Pet-Series/Pet-Mk-IV/doc/README.md

# README: /doc/ 

Sub-folder in the https://github.com/Pet-Series/Pet-Mk-IV repository.</br>
Content: Photo log book and image library.

## **Photos of Pet-Mk.IV**
<table style="width:100%">
  <tr>
    <th>Images</th>
    <th>Idol portrait from 📸 log-book</th>
    <th>admirers and ponder this 🤩</th>
  </tr>
  <tr>
    <td></td>
    <td></td>
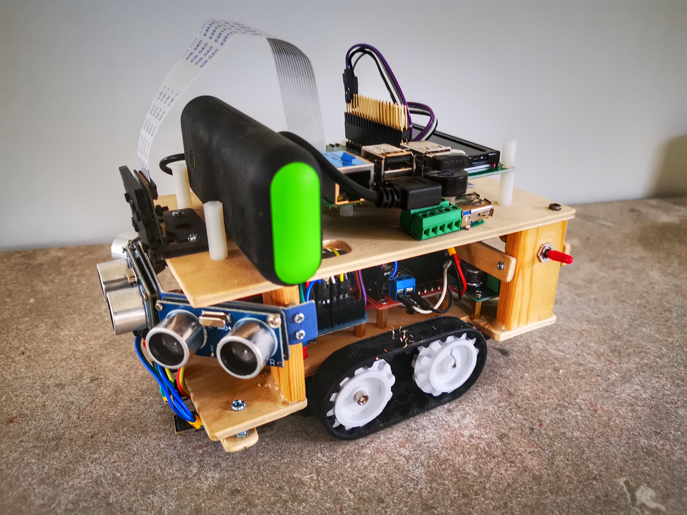
[picture p15: doc/pet_mk_iv-view_frontLeft.jpg]
    <td></td>
  </tr>
  <tr>
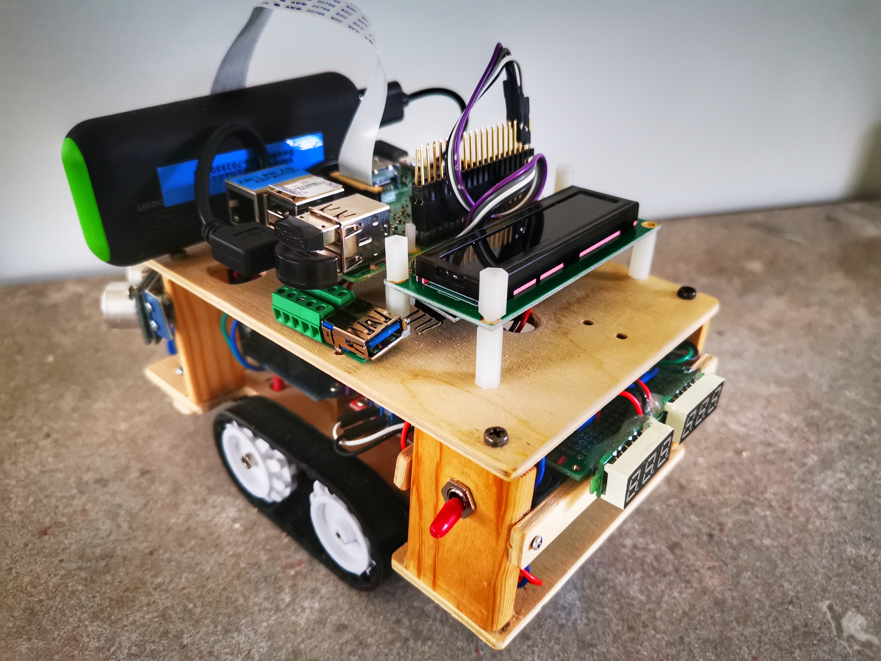
[picture p16: doc/pet_mk_iv-view_rearLeft.jpg]
    <td></td>
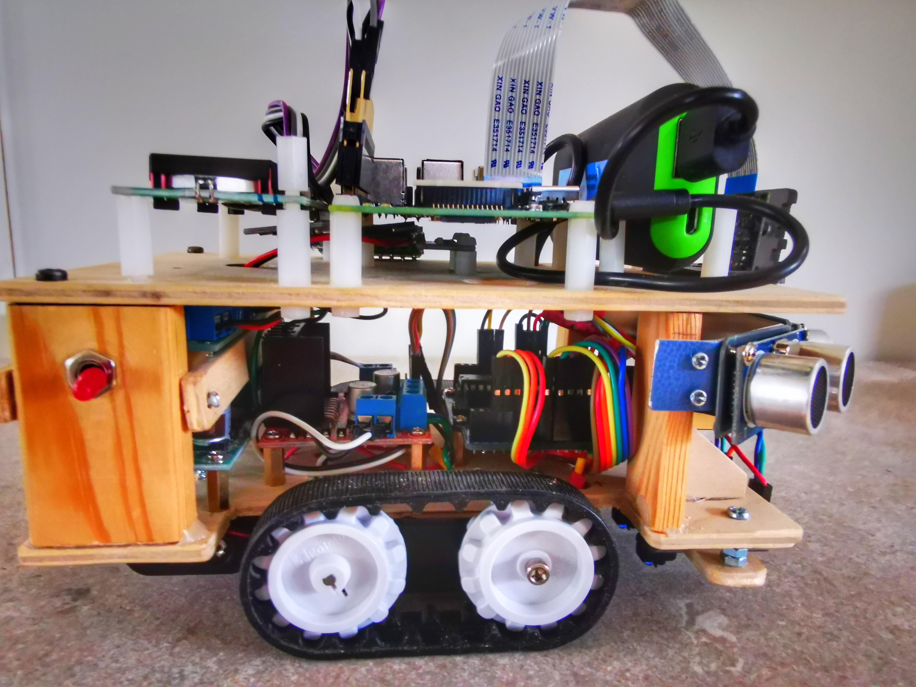
[picture p17: doc/pet_mk_iv-view_right.jpg]
    <td></td>
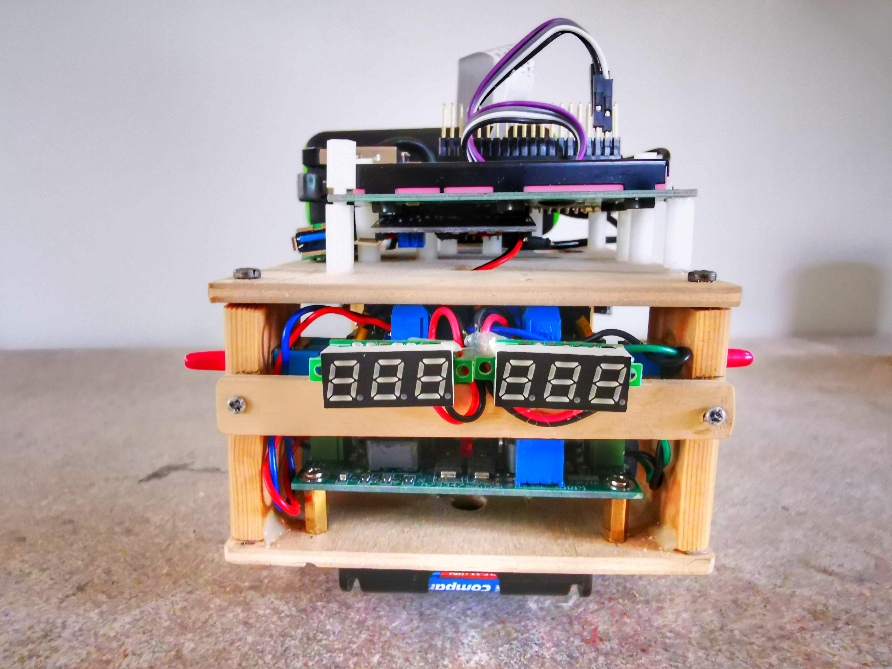
[picture p18: doc/pet_mk_iv-view_rear.jpg]
    <td></td>
  </tr>
  <tr>
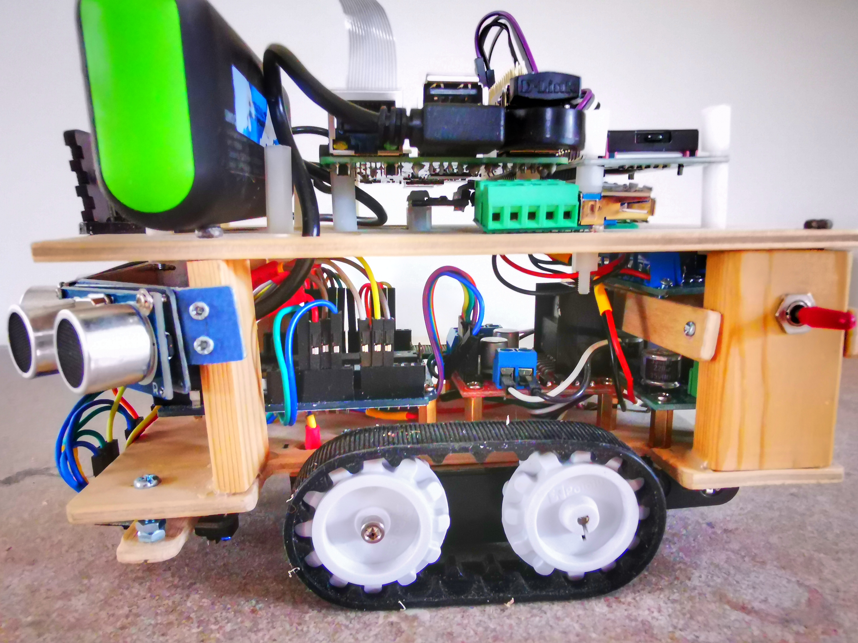
[picture p19: doc/pet_mk_iv-view_left.jpg]
    <td></td>
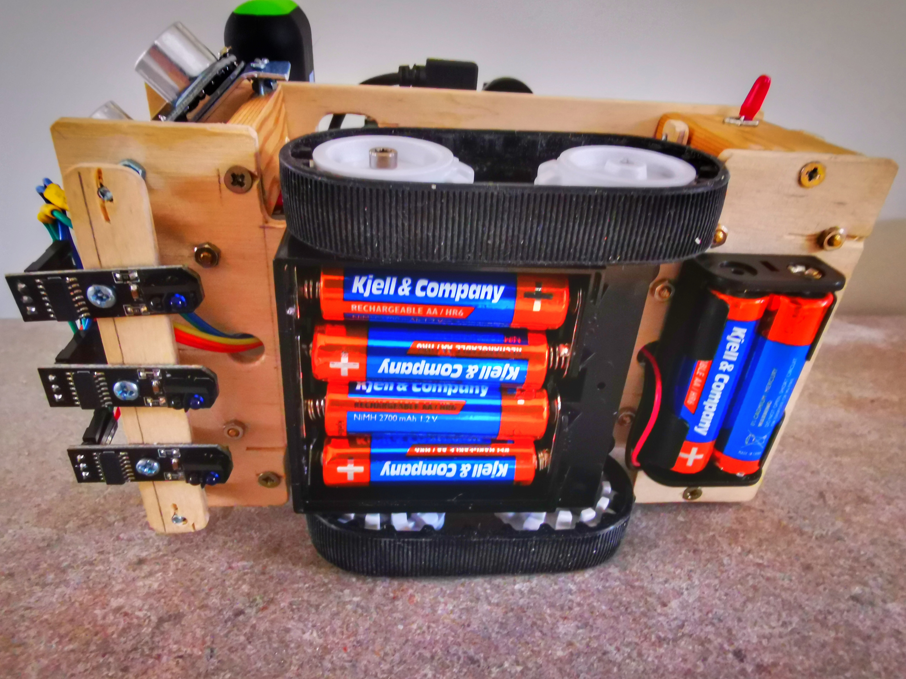
[picture p20: doc/pet_mk_iv-battery_compartment.jpg]
    <td></td>
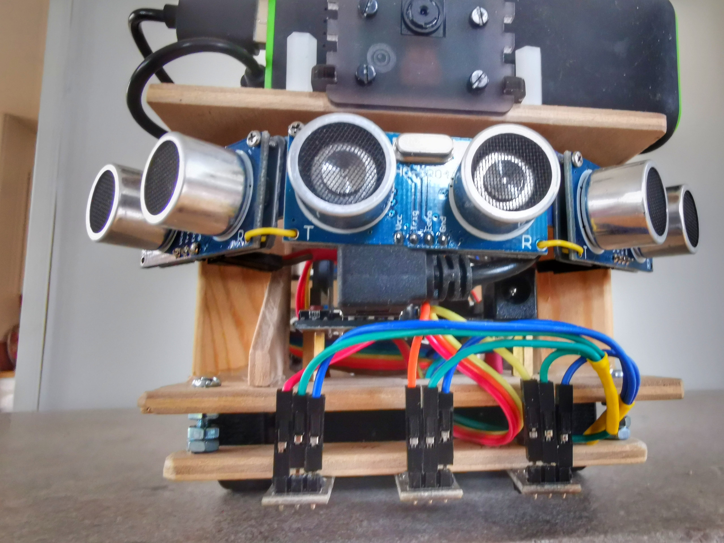
[picture p21: doc/pet_mk_iv-view_front.jpg]
    <td></td>
  </tr>
   <tr>
    <td></td>
    <td></td>
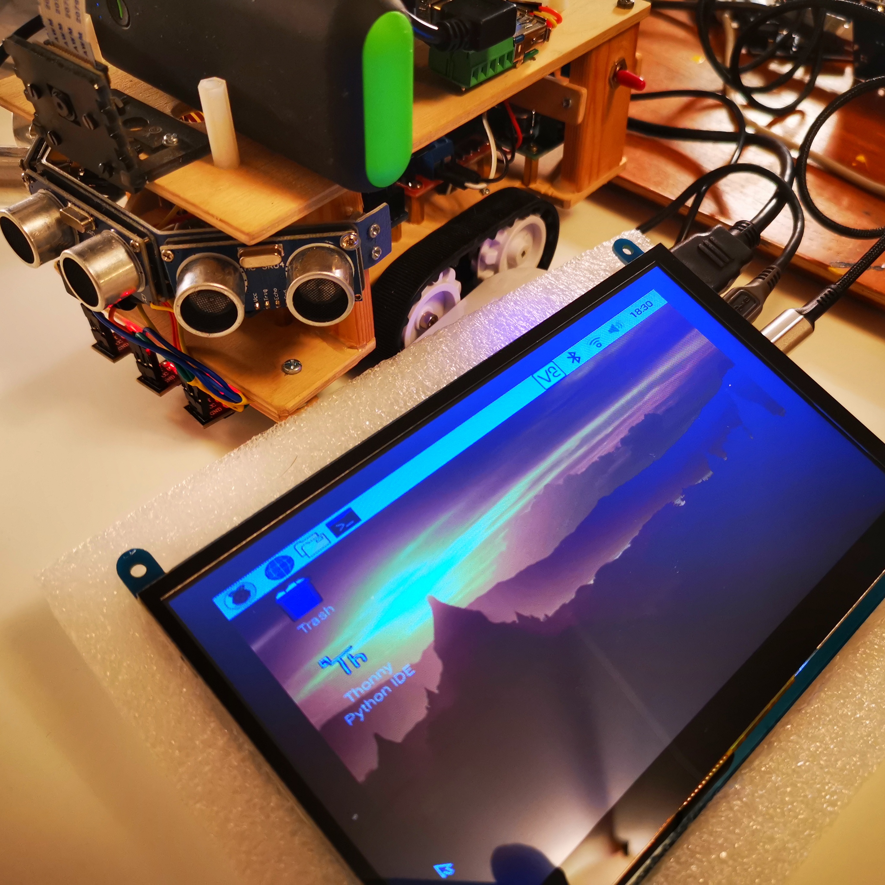
[picture p22: doc/pet_mk_iv-with_7inch_LCD_screen.jpg]
    <td></td>
  </tr>
  <tr>
    <td></td>
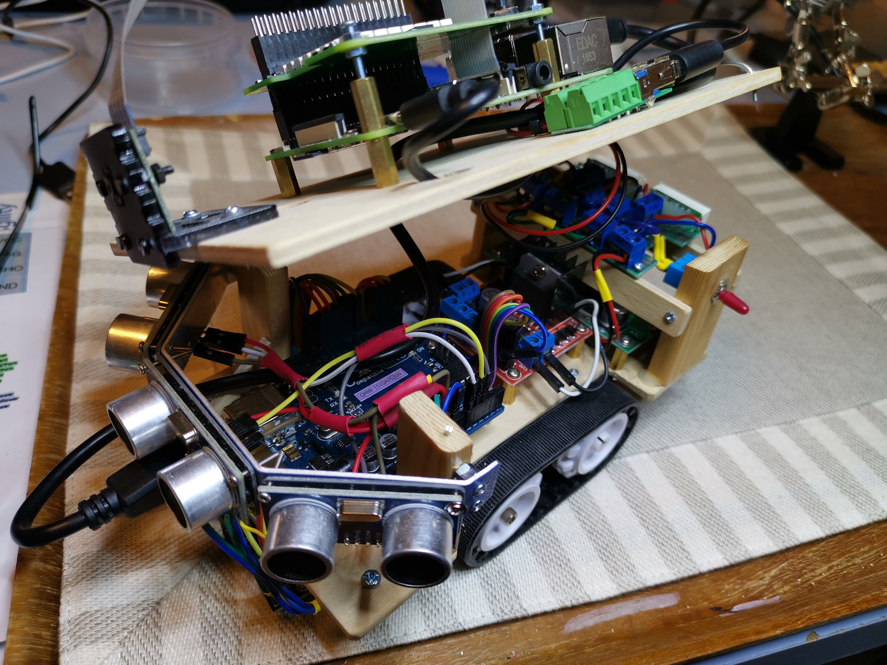
[picture p23: doc/pet_mk_iv-build_phase20.jpg]
    <td></td>
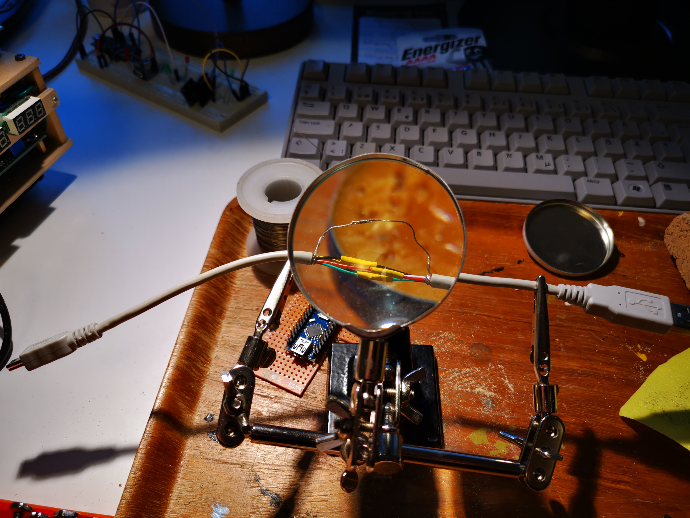
[picture p24: doc/pet_mk_iv-making_cabels.jpg]
    <td></td>
  </tr>
</table>

## **Images of the virtual twin:**
<table style="width:100%">
  <tr>
    <th>Images</th>
    <th>Idol rendering from RViz and Gazebo</th>
    <th></th>
  </tr>
  <tr>
    <td></td>
    <td></td>
    <td></td>
  </tr>
  <tr>
    <td></td>
    <td></td>
    <td</td>
  </tr>
</table>

<hr />
<br />

## **Drawing/Schemas:**
<table style="width:100%">
  <tr>
    <th>Images</th> 
    <th>Wiring🔌diagram</th>
    <th>📑</th>
  </tr>
  <tr>
    <td><br>Circuit Diagram - UNO</td>
    <td><br>Circuit Diagram - NANO</td>
    <td><br>Circuit Diagram - RPi</td>
  </tr>
  <tr>
    <td><br>PowerDistributionSchema</td>
    <td><br>PowerDistributionBoard</td>
    <td></td>
  </tr>
</table>

<hr />
<br />
 
## Test images: 
### A picture to the right (HTML formatted (48x48px))

<hr />
<br />

<table style="width:100%">
  <tr>
    <th>1️⃣</th>
    <th>2️⃣</th>
    <th>3️⃣</th>
  </tr>
  <tr>
    <td></td>
    <td></td>
    <td></td>
  </tr>
  <tr>
    <td></td>
    <td>n/a</td>
    <td>n/a</td>
  </tr>
</table>
<hr />
<br />

### Avatar
