Pet-Series/Pet-Mk-IV/pet_mk_iv_description/README.md

# README.md: /pet_mk_iv_description/ #

Sub-folder in the https://github.com/Pet-Series/Pet-Mk-IV repository.</br>

## **What is this folder for?** ##

* This package contains the description of our robots and end effectors in terms of kinematics, joint limits, visual surfaces and collision space. 
  - The collision space is a simplified version of the visual description used to improve performance of collision checks. 
* The descriptions are based on the URDF format according to the URDF XML documentation. Also using .xacro-macro format files.
<table>
  <tr>
     <td>
        
    </td>
    <td>
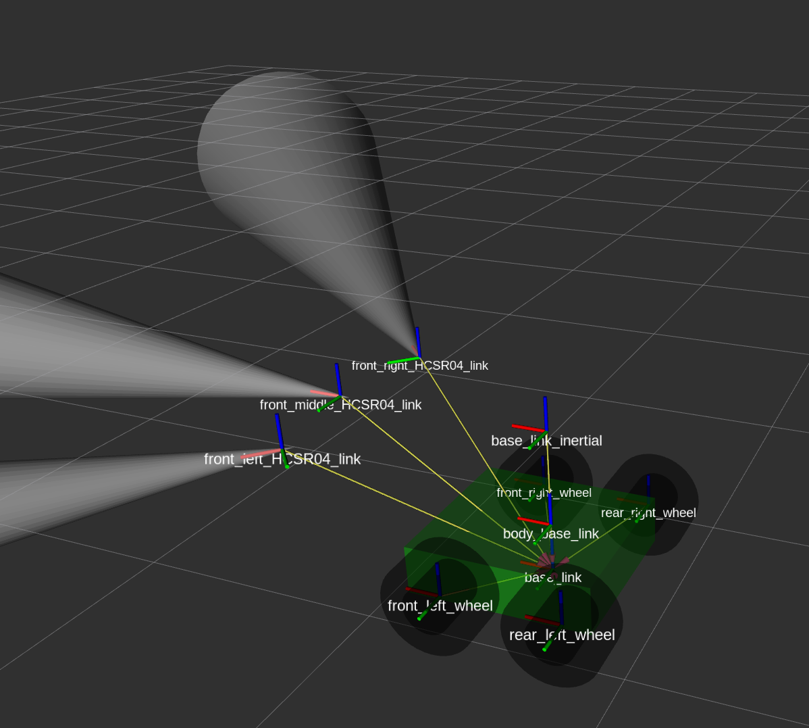
[picture p25: doc/pet_mk_iv-chassis_PololuZumo_and_sensor_link_tree.png]
        
    </td>
    <td>
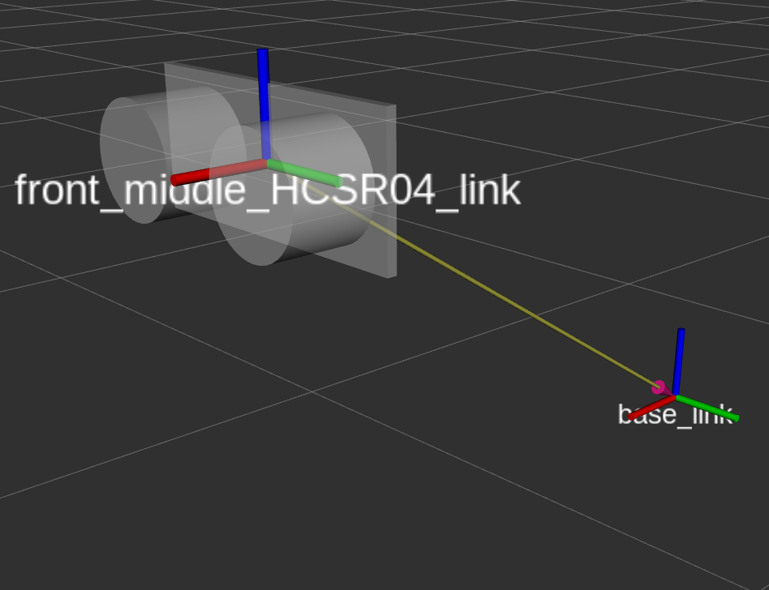
[picture p26: doc/pet_mk_iv-sensor_hc_sr04_sonarRange.urdf.xacro.png]
        
    </td>
  </tr>
</table>

## **Who do I talk to?** ##

* Repo owner: "Kullken" <karl.viktor.kull@gmail.com>
* Folder contributor: "SeniorKullken" <stefan.kull@gmail.com>
