Pet-Series/Pet-Mk-IV/Project_stuff/Images/readme.md

# Photo log book and image library
## **Photos:**
<table style="width:100%;background-color:#dddddd">
  <tr>
    <th>Images</th>
    <th>...from 📸 log book</th>
    <th>admirers and ponder this 🤩</th>
  </tr>
  <tr>
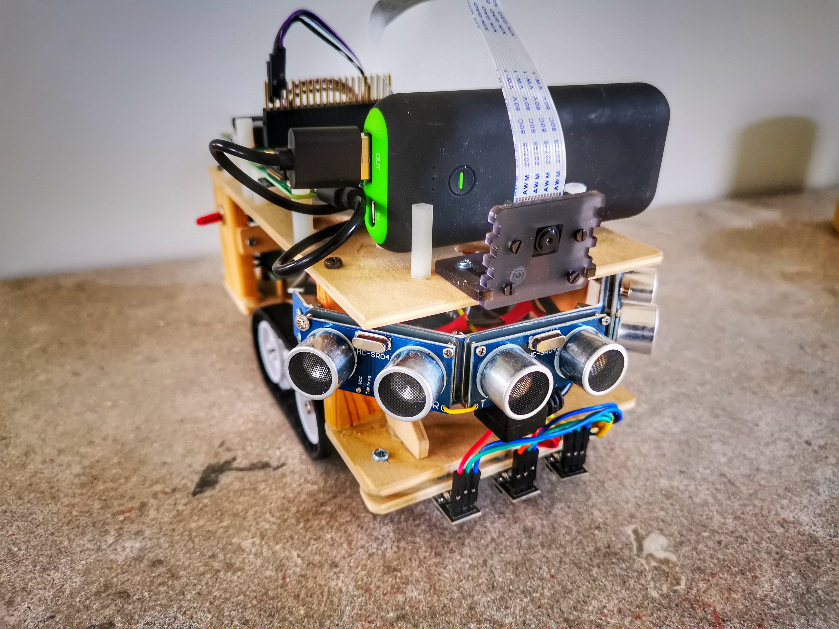
[picture p36: Project_stuff/Images/2019-09-09_121443-01.jpg]
    <td></td>
    <td></td>
    <td></td>
  </tr>
  <tr>
    <td></td>
    <td></td>
    <td></td>
  </tr>
  <tr>
    <td></td>
    <td></td>
    <td></td>
  </tr>
   <tr>
    <td></td>
    <td></td>
    <td>
    </td>
  </tr>
  <tr>
    <td></td>
    <td></td>
    <td></td>
  </tr>
   <tr>
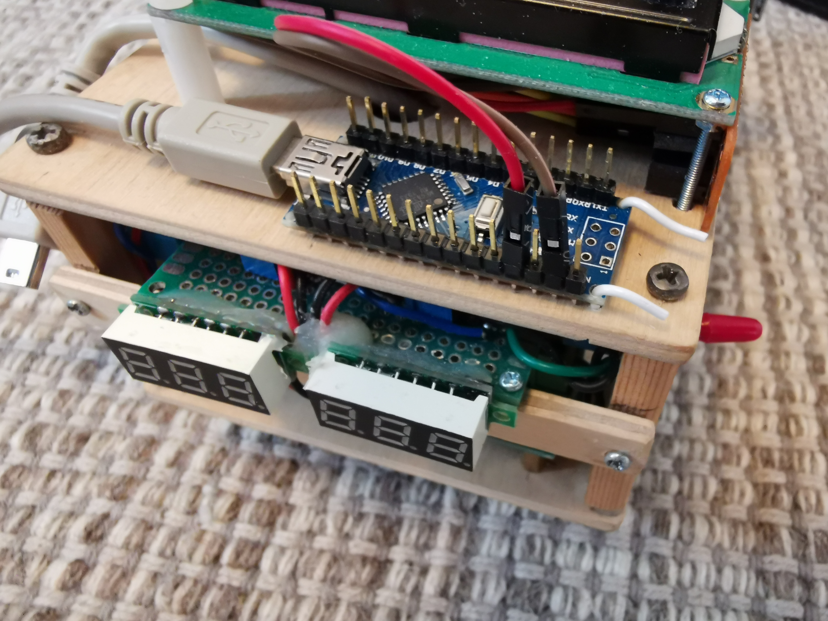
[picture p37: Project_stuff/Images/2020-05-15_123445.jpg]
    <td></td>
    <td></td>
    <td></td>
  </tr>
</table>
<hr />
<br />

## **Drawing/Schemas:**
<table style="width:100%">
  <tr>
    <th>Images</th> 
    <th>Wiring🔌diagram</th>
    <th>📑</th>
  </tr>
  <tr>
    <td><br>Circuit Diagram - UNO</td>
    <td><br>Circuit Diagram - NANO</td>
    <td><br>Circuit Diagram - RPi</td>
  </tr>
  <tr>
    <td><br>PowerDistributionSchema</td>
    <td><br>PowerDistributionBoard</td>
    <td></td>
  </tr>
</table>

<hr />
<br />
 
## Test images: 
### A picture to the right (HTML formatted (48x48px))

<hr />
<br />

<table style="width:100%">
  <tr>
    <th>1️⃣</th>
    <th>2️⃣</th>
    <th>3️⃣</th>
  </tr>
  <tr>
    <td></td>
    <td></td>
    <td></td>
  </tr>
  <tr>
    <td></td>
    <td>n/a</td>
    <td>n/a</td>
  </tr>
</table>
<hr />
<br />

### Avatar
