Pet-Series/Pet-Mk-IV/Linux/README.md

# README #

Folder in the https://github.com/kullken/Pet-Mk-IV repository.
Folder: ~/ros_ws/src/Pet-Mk-IV/pet_mk_iv_simulation/src/Linux

### What is this folder for? ###

Linux related files to be stored locally in Raspberry Pi (Not a ROS-package)
Utility scripts/setup files is to be run, outside ROS, by Linux during Linux-boot-up sequence.

### How do I get set up? ###

File locations:
* "**/home/pi/ros_ws/src/Pet-Mk-IV/Linux**" <- Files in this folder.
* "**/etc**" <- Files in the sub-folder "~/etc/*"

### Who do I talk to? ###

* Repo owner: "Kullken" <karl.viktor.kull@gmail.com>
* Folder contributor: "SeniorKullken" <stefan.kull@gmail.com>

###
:warning:Be aware:warning: You might get some "*close to hardware experiences*:neckbeard:".
