Pet-Series/Pet-Mk-IV/pet_mk_iv_description/mesh/pet_mk_iv_body.stl

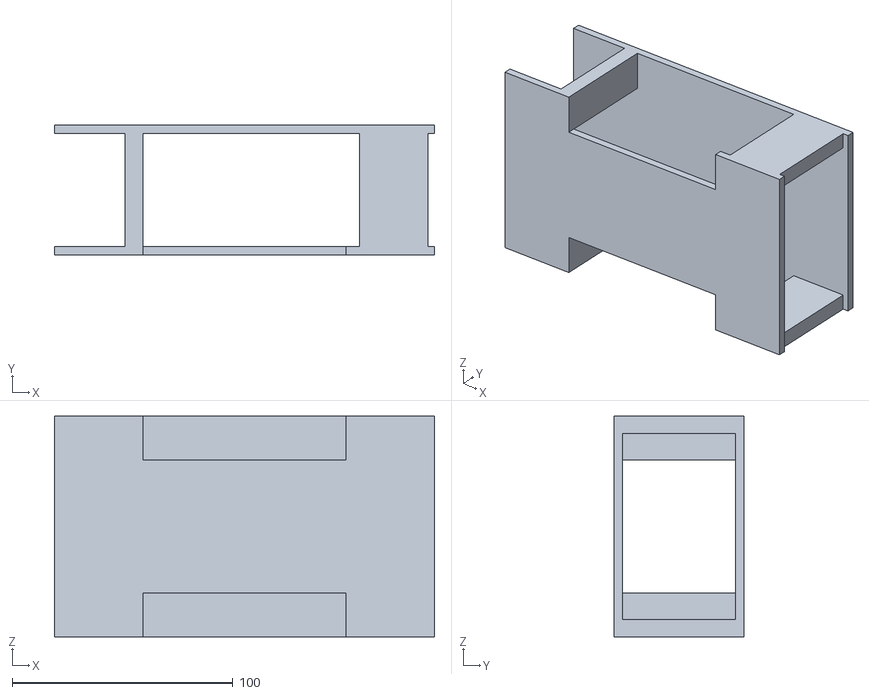
[picture p38: CAD file, 2021-06-19]
pet_mk_iv_description/mesh/pet_mk_iv_body.stl
172.0 x 59.0 x 100.0
