Pet-Series/Pet-Mk-IV/(threads)

Thread 2 (2019-10-12):

Setup raspiKull2 (Workbench/HIL)

kullken, 2019-10-12:
**Objective:**
- Setup a common workbench-RPi as an HIL-test bed (Hardware In the Loop)

**Checklist:**
- [x] Install Raspian melodic
- [x] Install ROS melodic
   - [x] Install ROS packages from Pet-Mk-IV github-project -> ~/ros_ws
         _Consider: What is common vs. What is unique for each Pet?_
   - [x] Custom ROS messages on arduino
- [x] Setup SSH
    - [x] Enable OpenSSH + add keys -> GitHub
      _See also: <#13 Connect target(RPi) systems to github-project via SSH-keys>_
    - [x] Enable OpenSSH + add keys for incoming traffic <- Viktor's "Tenebrous"
    - [x] Enable OpenSSH + add keys for incoming traffic <- Stefan's "Frigolit"
      ~~_See also: <Setting up developing env. on "Frigolit" #24>_~~
    - [x] Enable OpenSSH + add keys for incoming traffic <- Stefan's "Scania/Jobb" (aka "RD0067755")
- [x] Install Arduino IDE + library like NewPing

**Prerequisites:**
- [x] One RPi Ver 2B
- [x] One SD-card 8-16GB
- [x] Screen, Keyboard, Mouse

SeniorKullken, 2023-06-15:
Done long time ago...

Closed 2023-06-15.

Thread 9 (2019-10-20):

Custom ros.h in arduino sketch.

kullken, 2019-10-20:
A custom ros.h is needed to decrease memory buffer size used by rosserial. Currently the sketch is not compiling: "ros.h:4:29: error: ros/node_handle.h: No such file or directory".

SeniorKullken, 2020-10-07:
No relevant right now... I think :-)

Closed 2020-10-07.

Thread 22 (2020-03-11):

Embed ROS LCD-Publisher into mission ctrl. nodes

SeniorKullken, 2020-03-11:
**Objective:** Publish state/decision on LCD-display while running.

**Definition of done:** Update "Publisher" in `test_obstacle_detect_stop_turn.py`
- [x] Dist. sensors ▶️ `self.row1_pub = rospy.Publisher("lcd_display/row1", String, queue_size=10)`
- [x] State/Decisions   ▶️ `self.row2_pub = rospy.Publisher("lcd_display/row2", String, queue_size=10)`

**Prerequisites**: Existing subscriber for Topic  lcd_display/row1 and lcd_display/row1. (See #19)

SeniorKullken, 2020-10-07:
"Run Forrest run..."
"Obstacles all over the place"
Implemented & Tested

Closed 2020-10-07.

Thread 25 (2020-04-02):

HID: Auxiliary ROS-serial node (ArduinoNano) as IR-remote reciver

SeniorKullken, 2020-04-02:
**Objective:**
Human Interface Device(HID)
- Remote Start & stop via IR-remote.

**Definition of done:**
- [x] ROS-Serial on extra (Auxiliary) Arduino Nano.
- [x] Set up $udev rules for "/dev/ArduinoNano%c" and "/dev/ArdunioUni%c"
- [x] Hardware/Mechanics Done: IR-sensor + Arduino Ctrl mounted on Pet-Mk.IV
- [x] Implement support(subscribers) for remote start/stop-Topic.
- [x] Implement ROS-Serial for Arduino-node publishing "start/stop"-node.

**Prerequisites**:
- [x] Unit test done

SeniorKullken, 2020-10-07:
Implemented & tested

Closed 2020-10-07.

Thread 29 (2020-06-27):

HID: Flash/Strobe indicator (aka "Saftblandare")

SeniorKullken, 2020-06-27:
**Objective:**
Human Interface Device(HID)
- Visible motion feedback/Indicator/warning on top of vehicle (aka "Saftblandaren").
- Light with the following characteristics...
  > 1. Fast rotate
  > 2. Slow rotate
  > 3. Flash
  > 4. Strobe
  > 5. Off

**Definition of done:**
- [x] Hardware/Mechanics Done: Flash light connected to ROS-serial node "/dev/ArduinoNano0"
- [x] New message type for manipulating/controlling the characteristics of the flashlight.
- [x] Implement support(subscriber) for changing characteristics of the flashlight

**Prerequisites**:
- [x] #25 ROS-Serial on extra (Auxiliary) Arduino Nano

**Known issues that need to be manage**:
- Problem combining ROS Serial & servo-library.
  https://answers.ros.org/question/341697/unable-to-operate-servo-with-rosserial_arduino/
  http://wiki.ros.org/rosserial_arduino/Tutorials/Servo%20Controller

SeniorKullken, 2020-10-07:
Implemented & tested

Closed 2020-10-07.
