Pet-Series/Pet-Mk-IV/diagnos/RPi_OLEDdisplay_I2C/status.py

# Copyright (c) 2017 Adafruit Industries
# Author: Tony DiCola & James DeVito
#
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
import Adafruit_GPIO.SPI as SPI
import Adafruit_SSD1306

from PIL import Image
from PIL import ImageDraw
from PIL import ImageFont

import subprocess
import socket

# Raspberry Pi pin configuration:
RST = None     # on the PiOLED this pin isnt used
# Note the following are only used with SPI:
DC = 23
SPI_PORT = 0
SPI_DEVICE = 0

# 128x32 display with hardware I2C:
#disp = Adafruit_SSD1306.SSD1306_128_32(rst=RST)

# 128x64 display with hardware I2C:
disp = Adafruit_SSD1306.SSD1306_128_64(rst=RST)

# Note you can change the I2C address by passing an i2c_address parameter like:
# disp = Adafruit_SSD1306.SSD1306_128_64(rst=RST, i2c_address=0x3C)

# Alternatively you can specify an explicit I2C bus number, for example
# with the 128x32 display you would use:
# disp = Adafruit_SSD1306.SSD1306_128_32(rst=RST, i2c_bus=2)

# 128x32 display with hardware SPI:
# disp = Adafruit_SSD1306.SSD1306_128_32(rst=RST, dc=DC, spi=SPI.SpiDev(SPI_PORT, SPI_DEVICE, max_speed_hz=8000000))

# 128x64 display with hardware SPI:
# disp = Adafruit_SSD1306.SSD1306_128_64(rst=RST, dc=DC, spi=SPI.SpiDev(SPI_PORT, SPI_DEVICE, max_speed_hz=8000000))

# Alternatively you can specify a software SPI implementation by providing
# digital GPIO pin numbers for all the required display pins.  For example
# on a Raspberry Pi with the 128x32 display you might use:
# disp = Adafruit_SSD1306.SSD1306_128_32(rst=RST, dc=DC, sclk=18, din=25, cs=22)

# Initialize library.
disp.begin()

# Clear display.
disp.clear()
disp.display()

# Create blank image for drawing.
# Make sure to create image with mode '1' for 1-bit color.
width = disp.width
height = disp.height
image = Image.new('1', (width, height))
#print ("Width=", width)
#print ("Height=", height)

# Get drawing object to draw on image.
draw = ImageDraw.Draw(image)

# Draw a black filled box to clear the image.
draw.rectangle((0,0,width,height), outline=0, fill=0)

# Draw some shapes.
# First define some constants to allow easy resizing of shapes.
padding = -2
top = padding
bottom = height-padding
# Move left to right keeping track of the current x position for drawing shapes.
x = 0


# Load default font.
font = ImageFont.load_default()

# Alternatively load a TTF font.  Make sure the .ttf font file is in the same directory as the python script!
# Some other nice fonts to try: http://www.dafont.com/bitmap.php
# font = ImageFont.truetype('Minecraftia.ttf', 8)

while True:

    # Draw a black filled box to clear the image.
    draw.rectangle((0,0,width,height), outline=0, fill=0)

    # Shell scripts for system monitoring from here : https://unix.stackexchange.com/questions/119126/command-to-display-memory-usage-disk-usage-and-cpu-load
    HostName = socket.gethostname()
    
#    s = socket.socket(socket.AF_INET, socket.SOCK_DGRAM)
#    s.connect(("8.8.8.8", 80))
#    IP = s.getsockname()[0]
    
    IP = (([ip for ip in socket.gethostbyname_ex(socket.gethostname())[2] if not ip.startswith("127.")] or [[(s.connect(("8.8.8.8", 53)), s.getsockname()[0], s.close()) for s in [socket.socket(socket.AF_INET, socket.SOCK_DGRAM)]][0][1]]) + ["no IP found"])[0]
    
    #cmd = "hostname -I | cut -d\' \' -f1"
    #IP = subprocess.check_output(cmd, shell = True ).decode('utf-8')

    cmd = "top -bn1 | grep load | awk '{printf \"CPU Load: %.2f\", $(NF-2)}'"
    CPU = subprocess.check_output(cmd, shell = True ).decode('utf-8')
    
    cmd = "free -m | awk 'NR==2{printf \"Mem: %s/%sMB %.2f%%\", $3,$2,$3*100/$2 }'"
    MemUsage = subprocess.check_output(cmd, shell = True ).decode('utf-8')
    cmd = "df -h | awk '$NF==\"/\"{printf \"Disk: %d/%dGB %s\", $3,$2,$5}'"
    Disk = subprocess.check_output(cmd, shell = True ).decode('utf-8')

    # Write some lines of text.
    draw.text((x, top),    "Host: " + str(HostName),font=font, fill=255)
    draw.text((x, top+9),  "IP: " + str(IP),font=font, fill=255)
    draw.text((x, top+30),  str(CPU) + "%",        font=font, fill=255)
    draw.text((x, top+40), str(MemUsage),   font=font, fill=255)
    draw.text((x, top+50), str(Disk),       font=font, fill=255)
#    draw.text((x, top),    "Host: " + str(HostName),font=font, fill=255)
#    draw.text((x, top+8),  "IP: " + str(IP),font=font, fill=255)
#    draw.text((x, top+16),  str(CPU) + "%",        font=font, fill=255)
#    draw.text((x, top+24), str(MemUsage),   font=font, fill=255)
#    draw.text((x, top+32), str(Disk),       font=font, fill=255)

    # Display image.
    disp.image(image)
    disp.display()
    time.sleep(.1)
