Pet-Series/Pet-Mk-IV/diagnos/RPi_4chADconverter(ADS1115).py

#!/usr/bin/env python3
# coding = utf-8
 
################################################# ################################################# #########
### Copyright by Joy-IT
### Published under Creative Commons Attribution-NonCommercial-ShareAlike 3.0 Unported License
### Commercial use only after permission is requested and granted
###
### KY-053 Analog Digital Converter - Raspberry Pi Python Code Example
###
################################################# ################################################# #########
import time
import board
import busio
import adafruit_ads1x15.ads1115 as ADS
from adafruit_ads1x15.analog_in import AnalogIn

# Create the I2C bus
i2c = busio.I2C (board.SCL, board.SDA)

# Create the ADC object using the I2C bus
ads = ADS.ADS1115 (i2c)

# Create single-ended input on channels
chan0 = AnalogIn (ads, ADS.P0)  # nc.
chan1 = AnalogIn (ads, ADS.P1)  # Down=3.3v...Up=0.0v
chan2 = AnalogIn (ads, ADS.P2)  # CW=3.3v...CCW=0.0v
chan3 = AnalogIn (ads, ADS.P3)  # Left=3.3v...Right=0.0v



while True:
    print ("channel 0:", "{:> 5} \ t {:> 5.3f}". format (chan0.value, chan0.voltage))
    print ("channel 1:", "{:> 5} \ t {:> 5.3f}". format (chan1.value, chan1.voltage))
    print ("channel 2:", "{:> 5} \ t {:> 5.3f}". format (chan2.value, chan2.voltage))
    print ("channel 3:", "{:> 5} \ t {:> 5.3f}". format (chan3.value, chan3.voltage))
    print ("----------------------------------------------- ---- ")
    time.sleep (1)
