Pet-Series/Pet-Mk-IV/diagnos/RPi_Engine(L298N)_RPi/L298NHBridge.py

#!/usr/bin/env python
# coding: latin-1

# Autor:	Ingmar Stapel
# Date:		20141229
# Version:	1.0
# Homepage:	www.raspberry-pi-car.com

# This module is designed to control two motors with a L298N H-Bridge

# Use this module by creating an instance of the class. To do so call the Init function, then command as desired, e.g.
# import L298NHBridge
# HBridge = L298NHBridge.L298NHBridge()
# HBridge.Init()

# Import the libraries the class needs
import RPi.GPIO as io
io.setmode(io.BCM)

# Constant values
PWM_MAX                 = 100

# Disable warning from GPIO
io.setwarnings(False)

# Here we configure the GPIO settings for the left and right motors spinning direction. 
# It defines the four GPIO pins used as input on the L298 H-Bridge to set the motor mode (forward, reverse and stopp).

leftmotor_in1_pin = 27
leftmotor_in2_pin = 22
io.setup(leftmotor_in1_pin, io.OUT)
io.setup(leftmotor_in2_pin, io.OUT)

rightmotor_in1_pin = 24
rightmotor_in2_pin = 25
io.setup(rightmotor_in1_pin, io.OUT)
io.setup(rightmotor_in2_pin, io.OUT)

io.output(leftmotor_in1_pin, False)
io.output(leftmotor_in2_pin, False)
io.output(rightmotor_in1_pin, False)
io.output(rightmotor_in2_pin, False)

# Here we configure the GPIO settings for the left and right motors spinning speed. 
# It defines the two GPIO pins used as input on the L298 H-Bridge to set the motor speed with a PWM signal.

leftmotorpwm_pin = 4
rightmotorpwm_pin = 17

io.setup(leftmotorpwm_pin, io.OUT)
io.setup(rightmotorpwm_pin, io.OUT)

leftmotorpwm = io.PWM(leftmotorpwm_pin,100)
rightmotorpwm = io.PWM(rightmotorpwm_pin,100)

leftmotorpwm.start(0)
leftmotorpwm.ChangeDutyCycle(0)

rightmotorpwm.start(0)
rightmotorpwm.ChangeDutyCycle(0)

		
def setMotorMode(motor, mode):

# setMotorMode()

# Sets the mode for the L298 H-Bridge which motor is in which mode.

# This is a short explanation for a better understanding:
# motor		-> which motor is selected left motor or right motor
# mode		-> mode explains what action should be performed by the H-Bridge

# setMotorMode(leftmotor, reverse)	-> The left motor is called by a function and set into reverse mode
# setMotorMode(rightmotor, stopp)	-> The right motor is called by a function and set into stopp mode

	if motor == "leftmotor":
		if mode == "reverse":
			io.output(leftmotor_in1_pin, True)
			io.output(leftmotor_in2_pin, False)
		elif  mode == "forward":
			io.output(leftmotor_in1_pin, False)
			io.output(leftmotor_in2_pin, True)
		else:
			io.output(leftmotor_in1_pin, False)
			io.output(leftmotor_in2_pin, False)
			
	elif motor == "rightmotor":
		if mode == "reverse":
			io.output(rightmotor_in1_pin, False)
			io.output(rightmotor_in2_pin, True)		
		elif  mode == "forward":
			io.output(rightmotor_in1_pin, True)
			io.output(rightmotor_in2_pin, False)		
		else:
			io.output(rightmotor_in1_pin, False)
			io.output(rightmotor_in2_pin, False)
	else:
		io.output(leftmotor_in1_pin, False)
		io.output(leftmotor_in2_pin, False)
		io.output(rightmotor_in1_pin, False)
		io.output(rightmotor_in2_pin, False)

def setMotorLeft(power):

# SetMotorLeft(power)

# Sets the drive level for the left motor, from +1 (max) to -1 (min).

# This is a short explanation for a better understanding:
# SetMotorLeft(0)     -> left motor is stopped
# SetMotorLeft(0.75)  -> left motor moving forward at 75% power
# SetMotorLeft(-0.5)  -> left motor moving reverse at 50% power
# SetMotorLeft(1)     -> left motor moving forward at 100% power

	if power < 0:
		# Reverse mode for the left motor
		setMotorMode("leftmotor", "reverse")
		pwm = -int(PWM_MAX * power)
		if pwm > PWM_MAX:
			pwm = PWM_MAX
	elif power > 0:
		# Forward mode for the left motor
		setMotorMode("leftmotor", "forward")
		pwm = int(PWM_MAX * power)
		if pwm > PWM_MAX:
			pwm = PWM_MAX
	else:
		# Stopp mode for the left motor
		setMotorMode("leftmotor", "stopp")
		pwm = 0
#	print "SetMotorLeft", pwm
	leftmotorpwm.ChangeDutyCycle(pwm)

def setMotorRight(power):

# SetMotorRight(power)

# Sets the drive level for the right motor, from +1 (max) to -1 (min).

# This is a short explanation for a better understanding:
# SetMotorRight(0)     -> right motor is stopped
# SetMotorRight(0.75)  -> right motor moving forward at 75% power
# SetMotorRight(-0.5)  -> right motor moving reverse at 50% power
# SetMotorRight(1)     -> right motor moving forward at 100% power

	if power < 0:
		# Reverse mode for the right motor
		setMotorMode("rightmotor", "reverse")
		pwm = -int(PWM_MAX * power)
		if pwm > PWM_MAX:
			pwm = PWM_MAX
	elif power > 0:
		# Forward mode for the right motor
		setMotorMode("rightmotor", "forward")
		pwm = int(PWM_MAX * power)
		if pwm > PWM_MAX:
			pwm = PWM_MAX
	else:
		# Stopp mode for the right motor
		setMotorMode("rightmotor", "stopp")
		pwm = 0
#	print "SetMotorRight", pwm
	rightmotorpwm.ChangeDutyCycle(pwm)

def exit():
# Program will clean up all GPIO settings and terminates
	io.output(leftmotor_in1_pin, False)
	io.output(leftmotor_in2_pin, False)
	io.output(rightmotor_in1_pin, False)
	io.output(rightmotor_in2_pin, False)
	io.cleanup()
