Pet-Series/Pet-Mk-IV/pet_mk_iv_arduino/firmware/include/light_beacon.h

#ifndef PET_LIGHT_BEACON_H
#define PET_LIGHT_BEACON_H

#include <Servo.h>

#include <ros/duration.h>

#include <pet_mk_iv_msgs/LightBeacon.h>

#include "arduino_module.h"
#include "timer.h"

namespace pet
{

class LightBeacon : public ArduinoModule
{
private:
    static constexpr double kFrequency = 50;
    static constexpr ros::Duration kPeriod{1.0/kFrequency};

    // Pin to attach servo to.
    static constexpr int kServoPin = 3;     // Orange wire (PD2)
    static constexpr int kServoVCCPin = 2;  // Red wire    (PD3)

    // How long we have to wait for virtual servo to realise we have changed its position.
    static constexpr ros::Duration kPressDuration{0.05};

    // Fake 'On' position for the virtual servo. Specified in degrees.
    static constexpr int kServoOn  = 45;
    // Fake 'Off' position for the virtual servo. Specified in degrees.
    static constexpr int kServoOff = 135;

public:
    LightBeacon();

    ros::Time callback(const TimerEvent& event) override;

private:
    void mode_msg_callback(const pet_mk_iv_msgs::LightBeacon& msg);

    static constexpr ros::Duration period() { return kPeriod; }

    static constexpr ros::Duration press_duration() { return kPressDuration; }

private:
    Servo m_led_servo{};
    // NOTE: Hardware initialises to ROTATING_FAST mode when powered on.
    int m_current_mode = pet_mk_iv_msgs::LightBeacon::ROTATING_FAST;
    int m_desired_mode = pet_mk_iv_msgs::LightBeacon::OFF;

    int m_current_position = kServoOff;

    ros::Subscriber<pet_mk_iv_msgs::LightBeacon, LightBeacon> m_subscriber;
};

} // namespace pet

#endif // PET_LIGHT_BEACON_H
