Pet-Series/Pet-Mk-IV/(commit log)

2019-04-22 Working hello world from ros-arduino
2019-06-11 Testing ros::Time operators on arduino
2019-06-23 Added keyboard teleoperation
    [pet_mk_iv.sdf]
2019-07-16 Custom timer class on arduino
2019-07-16 Distance sensor message type
2019-07-24 Moved to Pet-Mk-IV_simulation
    [pet_mk_iv.sdf]
2019-07-29 IMU data publisher
2019-09-07 Bug fixes in IMU
    [imu_mpu6050.py]
2019-10-20 Refactored arduino sketch to compile on vscode
2019-10-20 Admire these pictures
    Some fan picture of PET-MkIV
2019-12-25 Custom nodehandle buffer size on arduino.
2019-12-25 Can now specifiy arduino serial port at launch.
2019-12-25 Towards integrating arduino firmware into ROS/catkin environment.
2020-01-02 Correct scale of IMU data.
    [imu_mpu6050.py]
2020-01-04 Refactored code for IMU MPU6050.
2020-01-04 IMU data scaled by sensitivity values.
2020-01-04 Added NEW node "pet_mk_iv_mission_control" - Test of distance sensors
2020-02-15 Made timer_test into the main sketch.
2020-02-15 Updated "pet_mk_iv_path_planner" Controller 10Hz->100Hz
2020-02-16 Build Arduino code with catkin+CMake instead of Arduino IDE.
2020-02-16 Added NEW pkg/node "ROS-LCD-Driver"
2020-02-25 Improved portability of Arduino CMake configuration.
2020-02-25 Added compile flags to Arduino firmware.
2020-03-14 Updated some code/comments "ROS LCD Driver"
2020-04-06 Unit test for RPi Camera
2020-05-02 Script for uploading to arduino.
2020-05-02 Create .launch-file for arduino.
2020-05-03 Lower hardcoded PWM in controller.
2020-05-03 Fixed frequency bug in timer.
2020-05-15 Publish ultra sound msg from outside of interrupt.
2020-05-15 Enable ultra sound sensor on arduino uno.
2020-05-15 Basic ROS-package for auxiliary Arduino/ECU.
2020-06-27 Refactor+fix of distance sensor code.
    [dist_sensors.cpp, dist_sensors.h]
2020-06-27 New Arduino device names from udev rules.
2020-06-27 Arduino via USB -> RPi naming rules in /dev/
2020-06-28 New test mission using multiple sensors.
2020-06-28 Add PWM-"offset" in controller.
2020-06-28 Cleanup in Arduino engine code.
2020-07-05 Create include+src folders for primary Arduino.
2020-07-05 Auxiliary Arduino is now chattering.
2020-07-05 Create include+src folders for auxiliary Arduino.
2020-07-05 Update arduino related scripts.
2020-07-05 Remove old guide for custom ROS msgs on Arduino.
2020-07-05 Stop primary arduino from chattering.
2020-07-06 Add namespaces to primary arduino.
2020-07-06 Arduino_aux: New irremote, Refact. chatter
2020-07-13 Rename + pkg.name=arduino_aux"
2020-07-13 Launch include 2x arduino
2020-07-19 Fix compatability with constexpr update in rosserial.
    [dist_sensors.h, engines.h, line_followers.h]
2020-07-19 Fix too small max callback count in timer.
2020-07-19 Cleanup SOURCE_FILES variables in arduino CMake.
2020-08-16 Add kalman filter skeleton
2020-08-16 Work in progress: ROS-node for kalman filter.
2020-08-16 Start on kalman filter prediction step
2020-08-17 Start to refactor into Arduino modules
    The goal is to have one Arduino binary to rule them all, and make it
    configurable with ROS-parameters at startup.
2020-08-18 Support IR-remote on aux-Arduino
2020-08-18 Unit test for Light Beacon (aka. Rotating LED)
2020-08-18 Include the Servo library in compilation
2020-08-18 Start on using Arduino program memory for strings
2020-08-23 Add work-in-progress framework of filter equations
2020-08-23 Implement measurement queue for Kalman filter
2020-08-23 Add sonar velocity measurement to Kalman filter
2020-08-30 Change order of state variables
    [theta, position, velocity] -> [theta, velocity, position]
2020-08-30 Implement sonar diff measurement Jacobians
2020-08-30 Specify what kind of velocity is measured
2020-08-30 Simplify filter latency checks
2020-08-30 Implement zero lateral velocity pseudo-measurement
2020-08-30 Set correct frame for publishing velocity estimate
2020-08-30 Set frame id:s of published messages only once
2020-09-12 Fix missing call to nh.subscribe()
    First tested/working implementation.
    [light_beacon.cpp]
2020-09-12 Rename LineFollowers->LineSensorModule
    Objective#1: New naming convetion for all Arduino modules -> +"_module".
    Objective#2: LineFollowers->LineSensorModule
    Note to self: Remember CMakeLists.txt for pet_mk_iv_arduino/firmware
2020-09-12 Add IR-remote module for arduino nano
2020-09-12 Improved print of IP-adress to LCD-display
2020-09-13 Control power to light beacon through VCC-pin
    This allows us to reset light beacon state without cutting power to the
    arduino.
    [light_beacon.cpp, light_beacon.h]
2020-10-04 Use new naming convention for all arduino modules
2020-12-03 Replace dynamic allocation with static
    Since we are not planning to use runtime configurable modules anymore,
    we might as well simplify both the code and memory profiling.
    [modules.cpp]
2021-04-05 Added Arduino Unit test "Scan I2C"
2021-04-05 HW test for Pet Mk. IV Ultrasound sensors (HC-04)
2021-04-05 HW test for Pet Mk.IV Ultrasound sensors (HC-04)
2021-04-07 Simple line sensor test on Pet Mk.V
2021-04-07 Simple wiring test for beacon @Pet Mk.V
2021-04-08 Pet Mk.V test of single line sensor - Test passed!
2021-04-08 Pet Mk.V test wiring for Beacon - Test passed!
2021-04-08 Pet Mk.V test scan I2C actuators/sensors = OK
2021-06-04 Correcting misspelled files & folders
    [RPi_3xUltraSoundSensors(HC-SR04).py]
2021-06-19 Cleaning & renaming Arduino unit tests
2021-06-19 New Pet Mk.IV Description (urdf, mesh and rviz)
    [HC_SR04_sonar.urdf.xacro, Pet Mk.IV Assy v4.stl, materials.xacro, pet_mk_iv.urdf.xacro, pet_mk_iv_gazebo.urdf.xacro, wheel.urdf.xacro]
2021-06-23 Gazebo: First /cmd_vel responsive version
    [pet_mk_iv.urdf.xacro, pet_mk_iv_gazebo.urdf.xacro, wheel.urdf.xacro]
2021-07-07 Major xacro/urdf description update New front camera New line sensors New IME sensor New Zumo Chassis Updated rviz-launch + rvic-cfg. Updated mesh
    [chassis_zumo.urdf.xacro, materials.xacro, pet_mk_iv.urdf.xacro, pet_mk_iv_body.stl, pet_mk_iv_gazebo.urdf.xacro, sensor_RPi_cameraV2.urdf.xacro, sensor_fc_123_lineDetector.urdf.xacro, sensor_hc_sr04_sonarRange.urdf.xacro]
2021-07-07 Added picture for each urdf/xacro component.
2021-07-08 New REDME.md describing .urdf/.xacro files.
2021-07-24 New pet_play_yards aas models and .worlds
    [model.sdf, pet_play_yard.world.xacro, pet_play_yard_01.blend, pet_play_yard_01_no_floor.blend, pet_play_yard_02.blend, pet_play_yard_03.blend]
2021-07-24 New line_sensor in Gazebo (camera -> Line sensor)
2021-07-27 Update name `pet_mcu_base` -> `pet_mcu_common`
    [chassis_zumo.urdf.xacro, pet_mk_iv.urdf.xacro, pet_mk_iv_gazebo.urdf.xacro, sensor_RPi_cameraV2.urdf.xacro, sensor_fc_123_lineDetector.urdf.xacro, sensor_hc_sr04_sonarRange.urdf.xacro, sensor_mpu6050_imu.urdf.xacro, visual_raspberryPi3B_sbc.urdf.xacro]
2021-08-03 Moved to 'pet_mk_iv_simulation' repo.
    [model.sdf, pet_play_yard.world.xacro, pet_play_yard_01.blend, pet_play_yard_01_no_floor.blend, pet_play_yard_02.blend, pet_play_yard_03.blend]
2021-09-12 Refactoring of toppics for sensors Changes due to Gazebo controller.
    [pet_mk_iv.urdf.xacro, pet_mk_iv_gazebo.urdf.xacro]
2021-10-24 fix: Avoid repetition of magic number (PET-4)
    [modules.cpp]
2021-11-03 Update /urdf/README.md
    Add some urdf/xml snippet into /urdf/README.md
2021-11-17 PET-28_Updated URDF with grip&bracket
    [pet_mk_iv.urdf.xacro]
2021-11-17 PET-28_New URDF.xacro for LCD1602-display
    [pet_mk_iv.urdf.xacro, visual_LCD1602.urdf.xacro]
2021-11-17 PET-28_Updated the README.md for LCD1602 urdf/xacro
2021-12-30 PET-37 Updates due to changed sensor topic names
2022-04-09 fix: Disable right&left range sensors
    We have reached the memory limit on the arduino uno, so we have to
    decrease memory usage to avoid crashes.
    [modules.cpp]
2022-04-09 fix: Update range sensor topic names
2023-06-17 New topic naming standard for Pet-Mk.IV
    [pet_mk_iv.urdf.xacro]
2023-07-02 Melodic->Noetic migration
    [pet_mk_iv.urdf.xacro]
