Pet-Series/Pet-Mk-IV/(notices)

Notices in the files:
diagnos/RPi_LCDdisplay_I2C(2x16)/lcd_i2c.py:
This program is free software: you can redistribute it and/or modify
it under the terms of the GNU General Public License as published by
the Free Software Foundation, either version 3 of the License, or
(at your option) any later version.
